kavindu2025123/StockSense/Project_Plan/October/Week_1/Domain_Problem_Brief.pdf

Summary of Inventory Problem Research

### 1. Pharmacies & Clinics

- Pain Points: High risk of dispensing expired medicines, manual stocktaking errors, undetected storage heat/humidity spoilage, and sudden stock-outs of critical drugs.
- StockSense Solution: Continuous weight-based quantity tracking, temperature/humidity threshold monitoring, automatic alerts prior to stock-outs, and batch/expiry tracking linked to bin RFID tags.

### 2. Garment & Manufacturing Factories

- Pain Points: Unplanned production line stoppages due to missing raw materials (buttons, zippers, fasteners), slow manual bin counting, and untracked scrap or wastage.
- StockSense Solution: Real-time edge monitoring of small-parts bins, automated reorder thresholds, and line-side stock visibility to prevent factory downtime.

### 3. Hotels, Restaurants & Cafés (HORECA)

- Pain Points: Inventory shrinkage/theft of high-value raw ingredients (spices, meats, liquor), excessive food waste from ingredient spoilage, and delayed stock takes.
- StockSense Solution: Real-time weight movement logging (flags unusual off-hours removals), humidity monitoring for dry store ingredients, and consumption pattern tracking.

### 4. Retail & Supermarkets

- Pain Points: High labor costs associated with manual shelf counting, hidden losses (mispicks or theft), and stock-outs leading to lost sales.
- StockSense Solution: Low-cost multi-bin shelf units, real-time quantity dashboards, and automated reorder recommendations.
