kavindu2025123/StockSense/Project_Plan/October/Week_1/StockSense - Tool Setup Checklist.pdf

# StockSense Workspace Setup

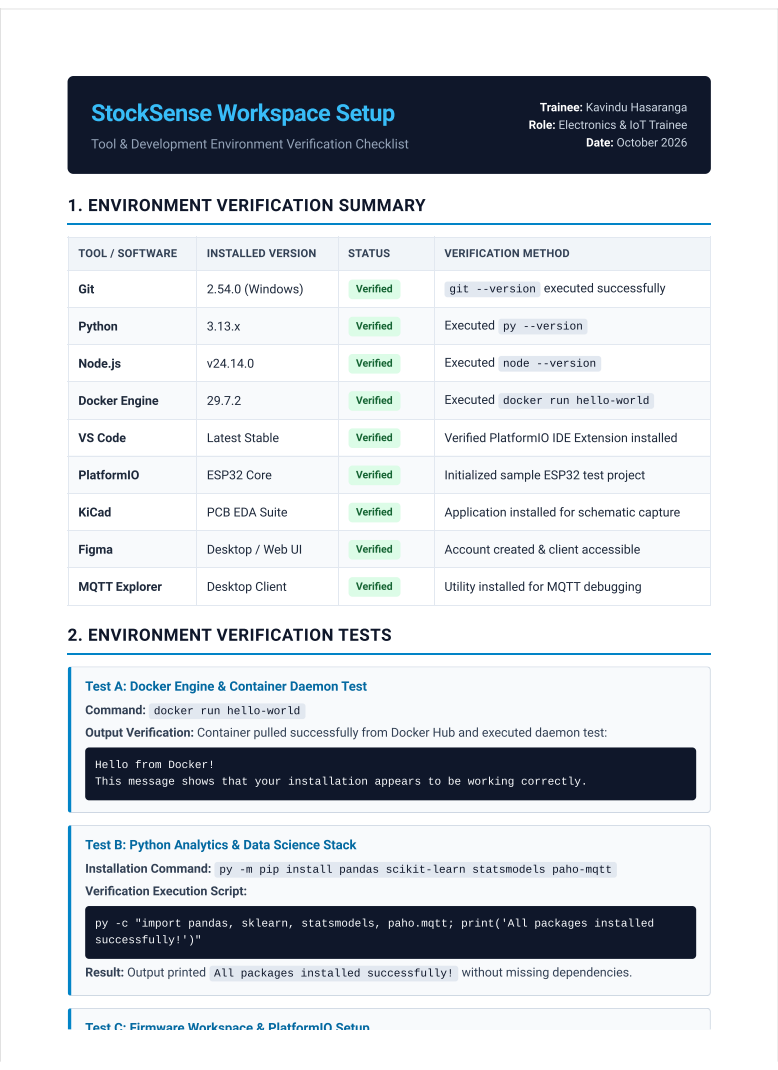
[picture p3: page 1]
Date: October 2026; successfully!')"

Trainee: Kavindu Hasaranga
Role: Electronics & IoT Trainee

Tool & Development Environment Verification Checklist

1. ENVIRONMENT VERIFICATION SUMMARY

TOOL / SOFTWARE | INSTALLED VERSION | STATUS | VERIFICATION METHOD

Git | 2.54.0 (Windows) | Verified | git --version executed successfully

Python | 3.13.x | Verified | Executed py --version

Node.js | v24.14.0 | Verified | Executed node --version

Docker Engine | 29.7.2 | Verified | Executed docker run hello-world

VS Code | Latest Stable | Verified | Verified PlatformIO IDE Extension installed

PlatformIO | ESP32 Core | Verified | Initialized sample ESP32 test project

KiCad | PCB EDA Suite | Verified | Application installed for schematic capture

Figma | Desktop / Web UI | Verified | Account created & client accessible

MQTT Explorer | Desktop Client | Verified | Utility installed for MQTT debugging

2. ENVIRONMENT VERIFICATION TESTS

Test A: Docker Engine & Container Daemon Test

Command: docker run hello-world

Output Verification: Container pulled successfully from Docker Hub and executed daemon test:

Hello from Docker!

This message shows that your installation appears to be working correctly.

Test B: Python Analytics & Data Science Stack

Installation Command: py -m pip install pandas scikit-learn statsmodels paho-mqtt

Verification Execution Script:

py -c "import pandas, sklearn, statsmodels, paho.mqtt; print('All packages installed

Result: Output printed All packages installed successfully! without missing dependencies.

Test C: Firmware Workspace & PlatformIO Setup

Codexus Technologies Confidential — StockSense Internship | Deliverable 01 | Page 1 of 1
