kavindu2025123/StockSense/Project_Plan/November/Week 1/StockSense.pdf

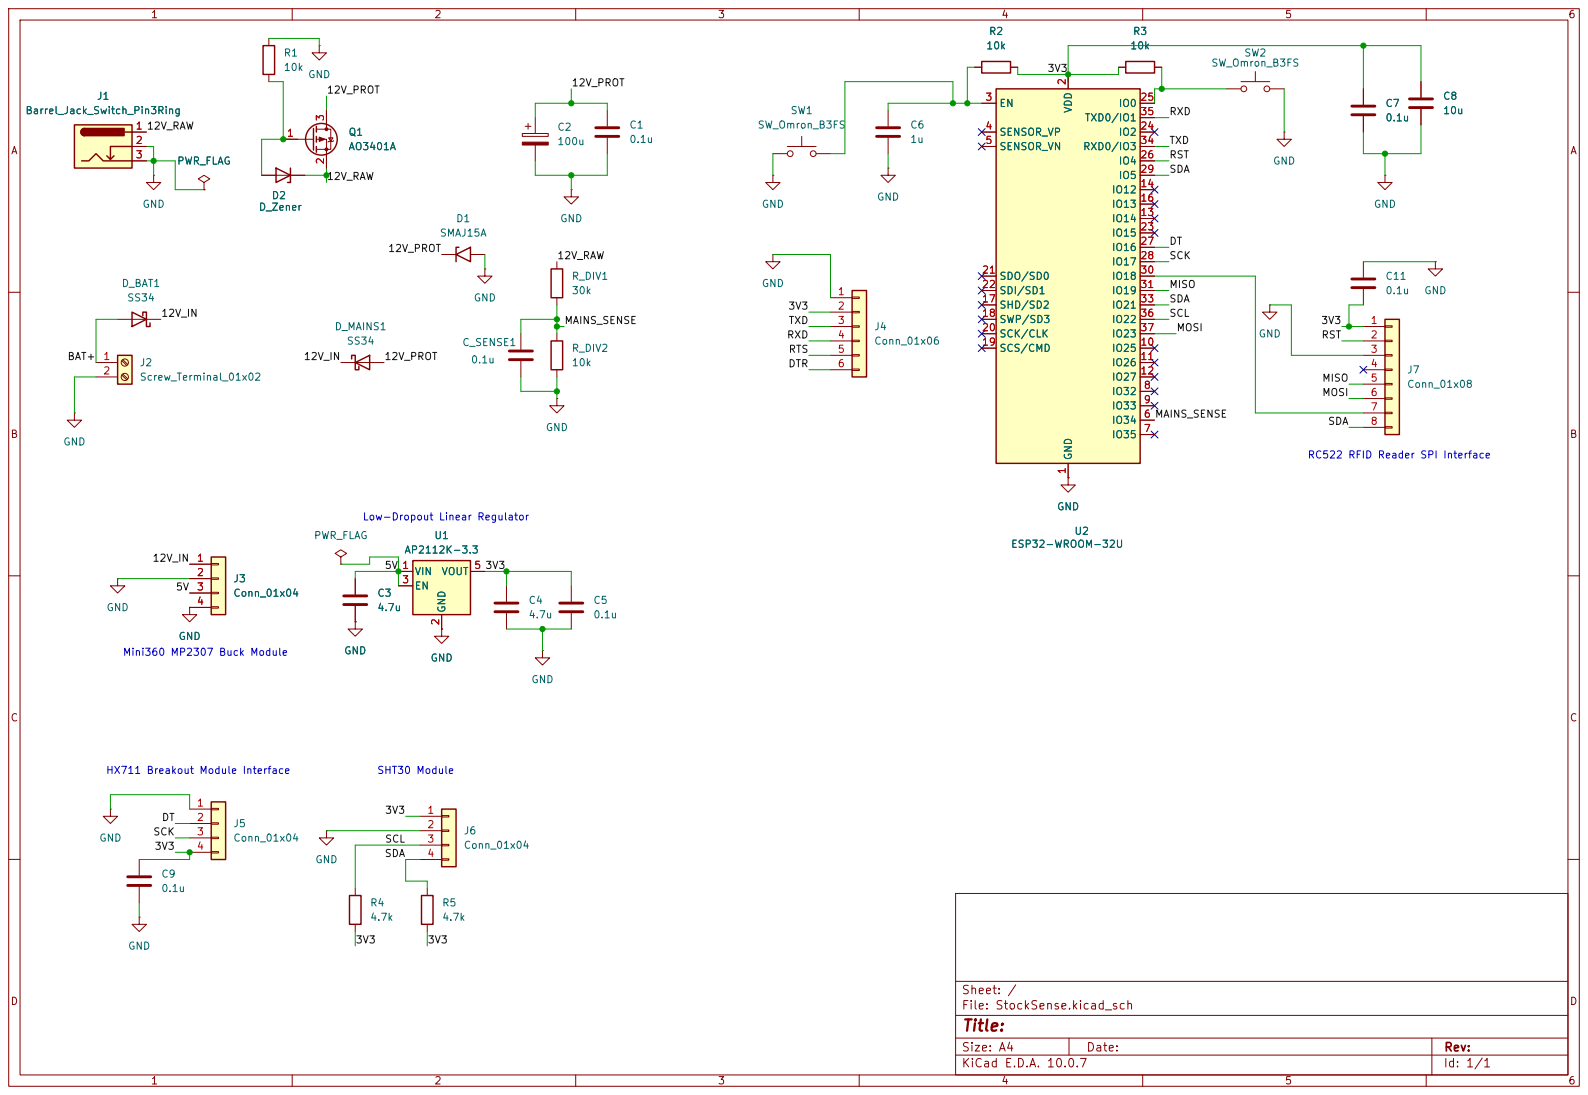
[picture p4: page 1]

Size: A4 | Rev:
KiCad E.D.A. 10.0.7 | Id: 1/1
