kavindu2025123/StockSense/Project_Plan/November/Week 1/StockSense.kicad_sch

## KiCad design Project_Plan/November/Week 1/StockSense.kicad_sch (2026-11-06)

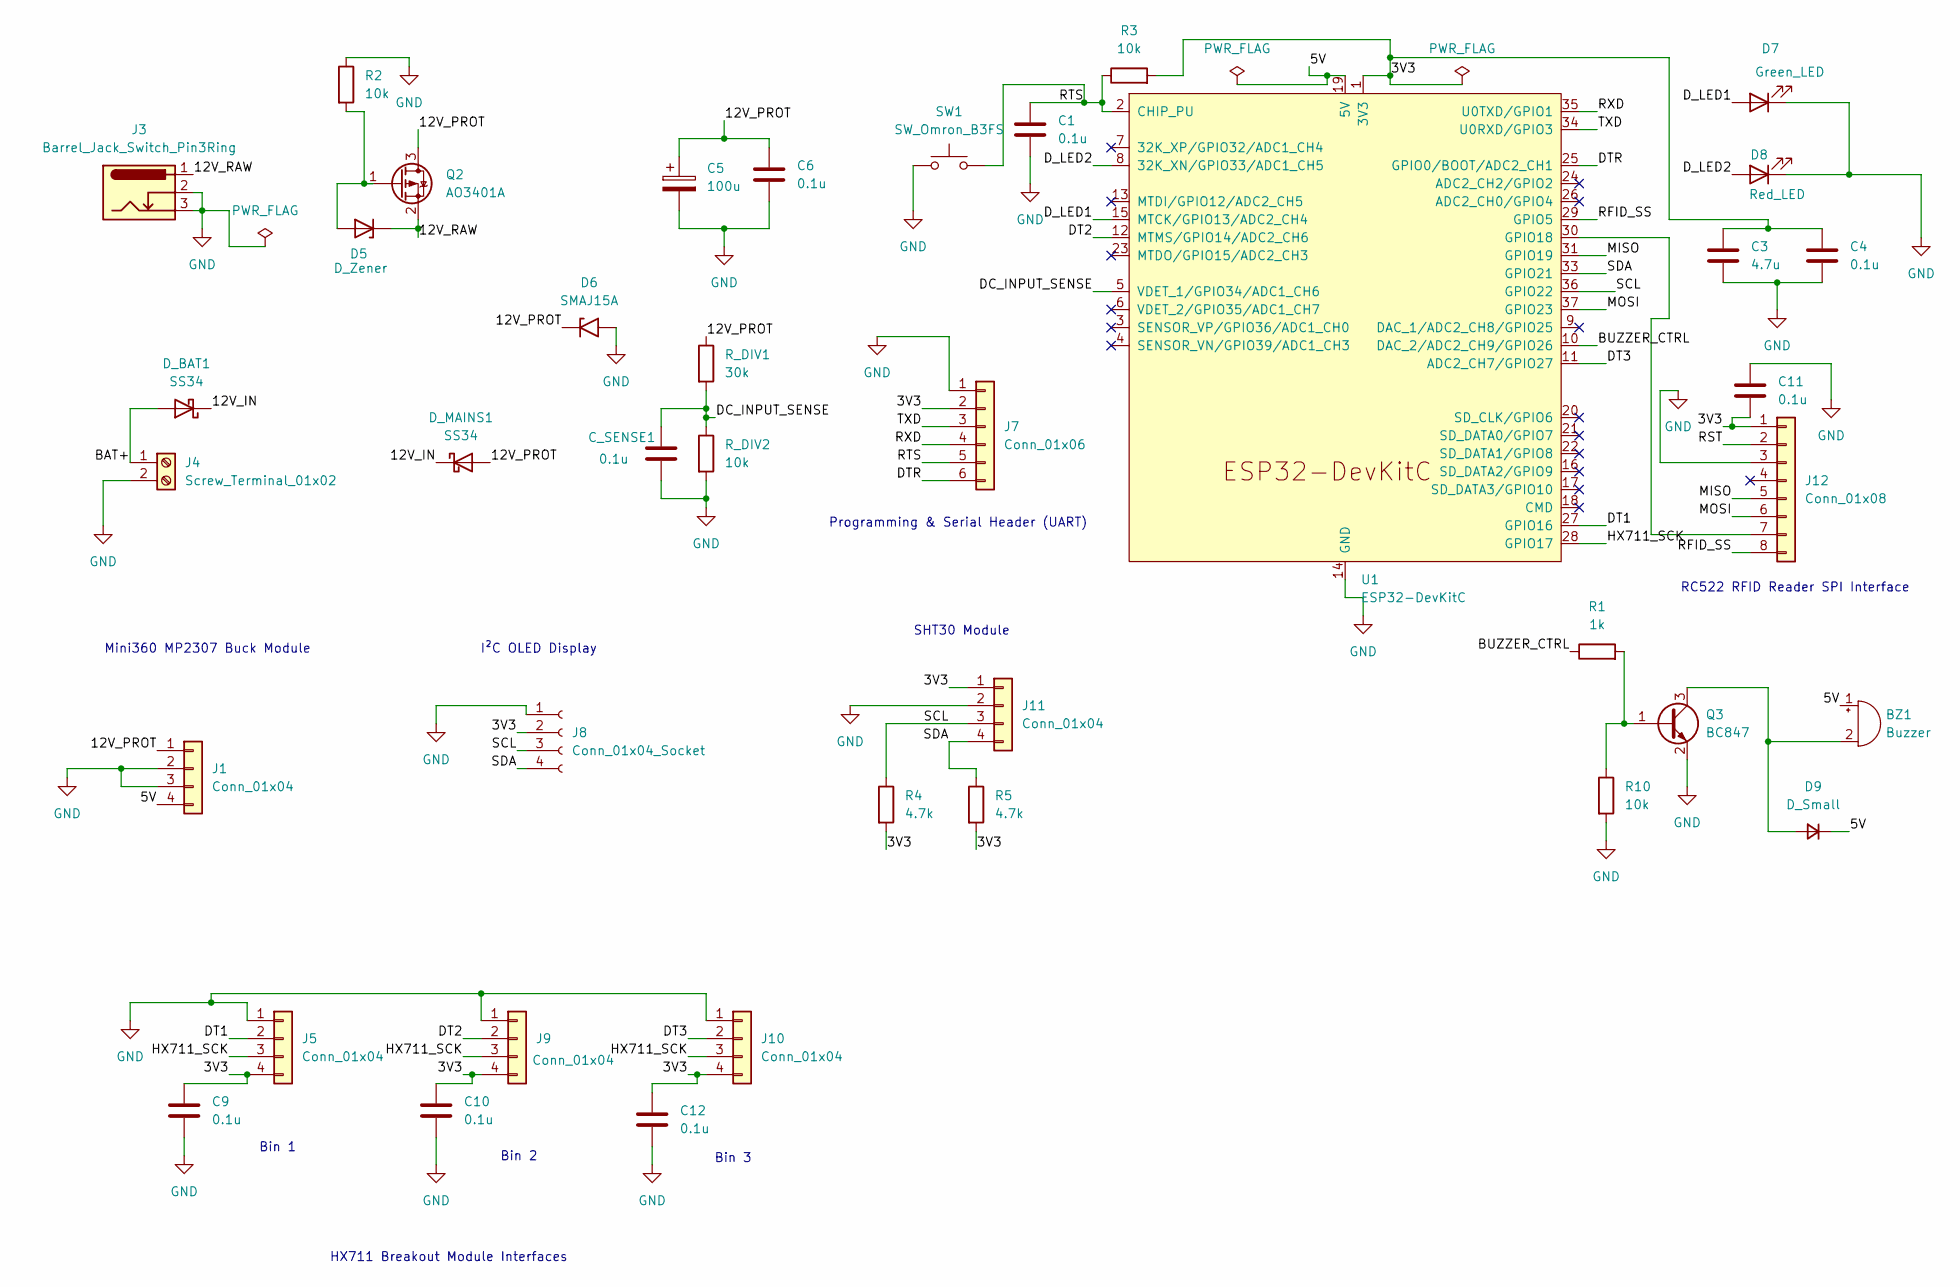
[picture p5: schematic StockSense.kicad_sch]

Parts:
BZ1: Buzzer; Buzzer_12x9.5RM7.6
C1, C4, C6, C9, C10, C11, C12: 0.1u; C_0805_2012Metric
C3: 4.7u; C_0805_2012Metric
C5: 100u; CP_Radial_D6.3mm_P2.50mm
C_SENSE1: 0.1u; C_0805_2012Metric
D5: D_Zener; SOT-23
D6: SMAJ15A; D_SMA
D7: Green_LED; LED_0805_2012Metric
D8: Red_LED; LED_0805_2012Metric
D9: D_Small; D_SMA
D_BAT1: SS34; D_SMA
D_MAINS1: SS34; D_SMA
J1: Conn_01x04; Mini360_MP2307_Module
J3: Barrel_Jack_Switch_Pin3Ring; BarrelJack_Horizontal
J4: Screw_Terminal_01x02; TerminalBlock_Phoenix_MKDS-1,5-2-5.08_1x02_P5.08mm_Horizont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
J5, J9, J10, J11: Conn_01x04; PinHeader_1x04_P2.54mm_Vertical
J7: Conn_01x06; PinHeader_1x06_P2.54mm_Vertical
J8: Conn_01x04_Socket; PinSocket_1x04_P2.54mm_Vertical
J12: Conn_01x08; PinHeader_1x08_P2.54mm_Vertical
Q2: AO3401A; SOT-23
Q3: BC847; SOT-23
R1: 1k; R_0805_2012Metric
R2, R3, R10: 10k; R_0805_2012Metric
R4, R5: 4.7k; R_0805_2012Metric
R_DIV1: 30k; R_0805_2012Metric
R_DIV2: 10k; R_0805_2012Metric
SW1: SW_Omron_B3FS; SW_PUSH_6mm_H4.3mm
U1: ESP32-DevKitC

Connections:
3V3: C3.1, C4.1, C9.1, C10.1, C11.2, C12.1, J5.4, J7.2, J8.2, J9.4, J10.4, J11.1, J12.1, R3.2, R4.2, R5.2, U1.1 (3V3)
5V: BZ1.1 (+), D9.1 (K), J1.4, U1.19 (5V)
12V_IN: D_BAT1.1 (K), D_MAINS1.1 (K)
12V_PROT: C5.1, C6.1, D6.1 (A1), D_MAINS1.2 (A), J1.1, Q2.3 (D), R_DIV1.1
12V_RAW: D5.1 (K), J3.1, Q2.2 (S)
BAT+: D_BAT1.2 (A), J4.1
BUZZER_CTRL: R1.1, U1.10 (DAC_2/ADC2_CH9/GPIO26)
DC_INPUT_SENSE: C_SENSE1.1, R_DIV1.2, R_DIV2.1, U1.5 (VDET_1/GPIO34/ADC1_CH6)
DT1: J5.2, U1.27 (GPIO16)
DT2: J9.2, U1.12 (MTMS/GPIO14/ADC2_CH6)
DT3: J10.2, U1.11 (ADC2_CH7/GPIO27)
DTR: J7.6, U1.25 (GPIO0/BOOT/ADC2_CH1)
D_LED1: D7.2 (A), U1.15 (MTCK/GPIO13/ADC2_CH4)
D_LED2: D8.2 (A), U1.8 (32K_XN/GPIO33/ADC1_CH5)
GND: C1.2, C3.2, C4.2, C5.2, C6.2, C9.2, C10.2, C11.1, C12.2, C_SENSE1.2, D6.2 (A2), D7.1 (K), D8.1 (K), J1.2, J1.3, J3.2, J3.3, J4.2, J5.1, J7.1, J8.1, J9.1, J10.1, J11.2, J12.3, Q3.2 (E), R2.1, R10.2, R_DIV2.2, SW1.1, U1.14 (GND), U1.32 (GND), U1.38 (GND)
HX711_SCK: J5.3, J9.3, J10.3, U1.28 (GPIO17)
MISO: J12.5, U1.31 (GPIO19)
MOSI: J12.6, U1.37 (GPIO23)
unnamed: BZ1.2 (-), D9.2 (A), Q3.3 (C)
unnamed: D5.2 (A), Q2.1 (G), R2.2
unnamed: J12.7, U1.30 (GPIO18)
unnamed: Q3.1 (B), R1.2, R10.1
RFID_SS: J12.8, U1.29 (GPIO5)
RST: J12.2
RTS: C1.1, J7.5, R3.1, SW1.2, U1.2 (CHIP_PU)
RXD: J7.4, U1.35 (U0TXD/GPIO1)
SCL: J8.3, J11.3, R4.1, U1.36 (GPIO22)
SDA: J8.4, J11.4, R5.1, U1.33 (GPIO21)
TXD: J7.3, U1.34 (U0RXD/GPIO3)

Notes on the sheet:
Mini360 MP2307 Buck Module
Bin 3
Bin 1
Programming & Serial Header (UART)
SHT30 Module
HX711 Breakout Module Interfaces
I²C OLED Display
RC522 RFID Reader SPI Interface
Bin 2
