kavindu2025123/StockSense/(commit log)

2026-11-04 Add Week 5 deliverable: StockSense PCB Costed BOM v1 PDF and LTspice.asc file
2026-11-04 Add Week 5 deliverable: StockSense.sch PDF and StockSense.kicad_sch file
